MagicPhoenix/MPX-VORON-24R2-KIT/README.md

# VORON 2.4R2 KIT 

Repository for MagicPhoenix 2.4 R2 KIT.

For more detail, please visit https://mpx.wiki 

## Note

This repo is for old kits, for CBT kit please check https://github.com/MagicPhoenix/MPX-VORON-24R2-CBT
