MagicPhoenix/MPX-VORON-24R2-KIT/Assembly/PSU_Mount_Printed_Parts.png

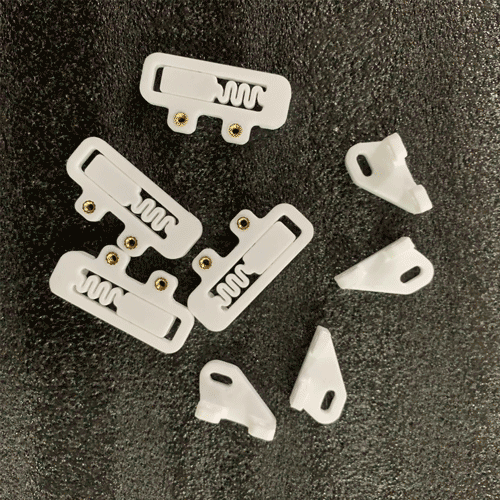
Assembly/PSU_Mount_Printed_Parts.png
