MagicPhoenix/MPX-VORON-24R2-KIT/Printed Parts/Canbus/canable_pro_clip.stl

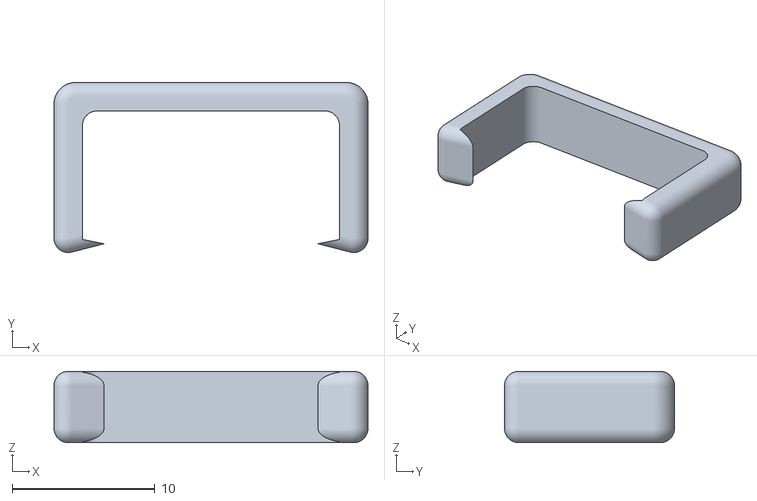
[picture p2: CAD file, 2023-08-08]
Printed Parts/Canbus/canable_pro_clip.stl
22.0 x 11.9 x 5.00
