MagicPhoenix/MPX-VORON-24R2-KIT/Printed Parts/Electronics_Mount/Rpi_Mount.STL

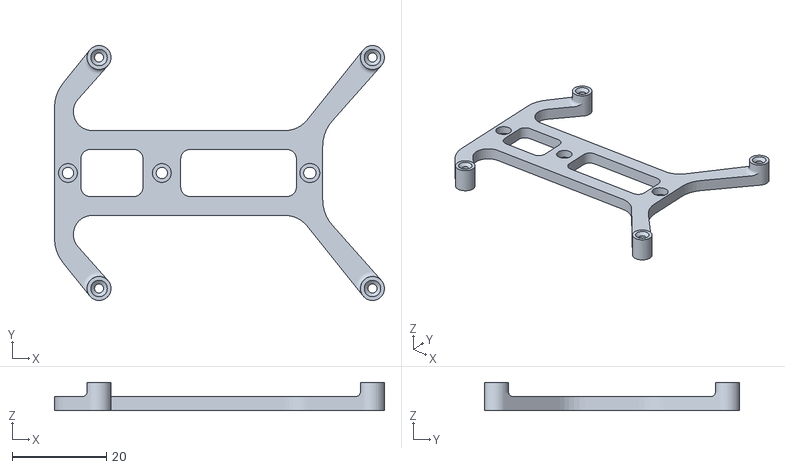
[picture p3: CAD file, 2022-06-08]
Printed Parts/Electronics_Mount/Rpi_Mount.STL
70.0 x 54.1 x 6.00
