MagicPhoenix/MPX-VORON-24R2-KIT/Printed Parts/Toolboard_Afterburner/Afterburner_Cover.STL

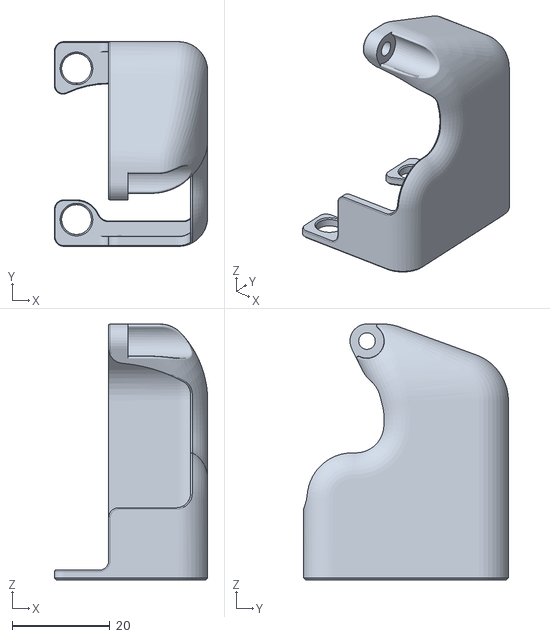
[picture p4: CAD file, 2022-04-11]
Printed Parts/Toolboard_Afterburner/Afterburner_Cover.STL
31.4 x 42.0 x 52.5
