MagicPhoenix/MPX-VORON-24R2-KIT/Printed Parts/Toolboard_Stealthburner/Stealthburner_Toolhead_PCB_Mount.STL

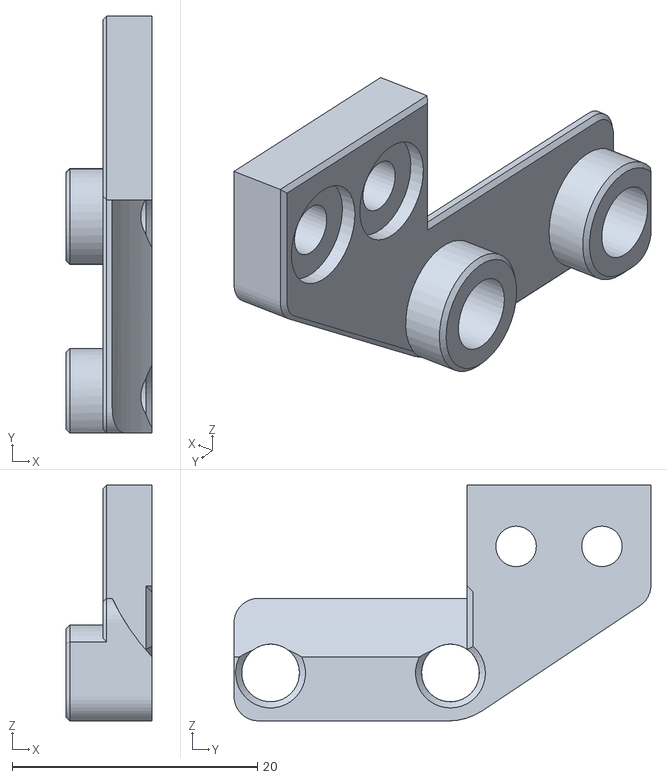
[picture p5: CAD file, 2022-04-03]
Printed Parts/Toolboard_Stealthburner/Stealthburner_Toolhead_PCB_Mount.STL
7.00 x 34.0 x 19.2
