MagicPhoenix/MPX-VORON-24R2-KIT/Printed Parts/Canbus/canable_pro_mount.stl

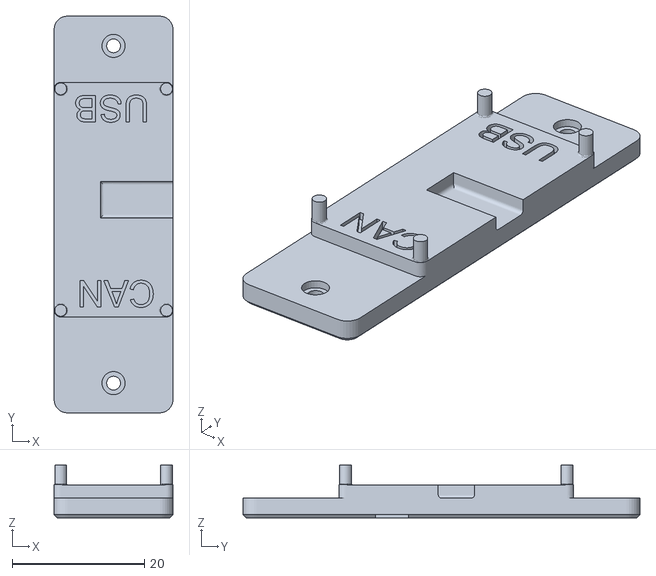
[picture p6: CAD file, 2023-08-08]
Printed Parts/Canbus/canable_pro_mount.stl
18.0 x 60.0 x 8.00
