MagicPhoenix/MPX-VORON-24R2-KIT/Printed Parts/Electronics_Mount/PSU_MOUNT_B_x2.stl

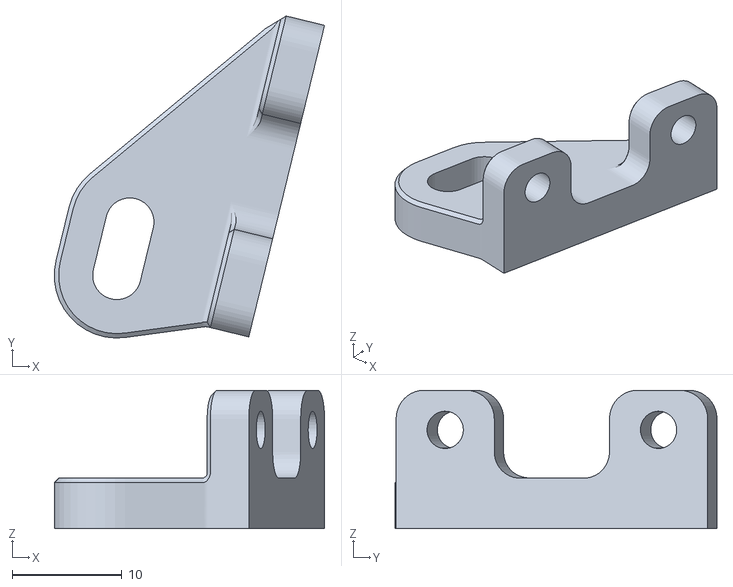
[picture p7: CAD file, 2022-04-09]
Printed Parts/Electronics_Mount/PSU_MOUNT_B_x2.stl
24.6 x 29.3 x 12.6
