MagicPhoenix/MPX-VORON-24R2-KIT/Printed Parts/Toolboard_Afterburner/Afterburner_Toolhead_PCB_Mount.STL

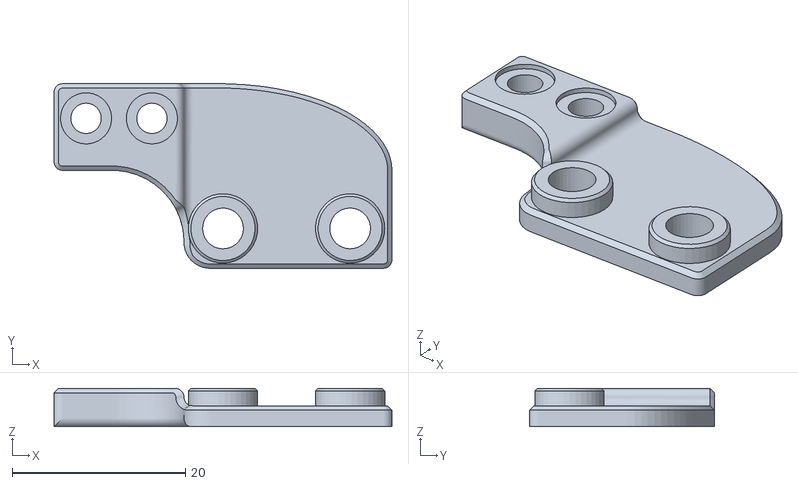
[picture p8: CAD file, 2022-04-11]
Printed Parts/Toolboard_Afterburner/Afterburner_Toolhead_PCB_Mount.STL
39.0 x 21.3 x 4.40
