MagicPhoenix/MPX-VORON-24R2-KIT/Printed Parts/Toolboard_Stealthburner/Stealthburner_Cover.STL

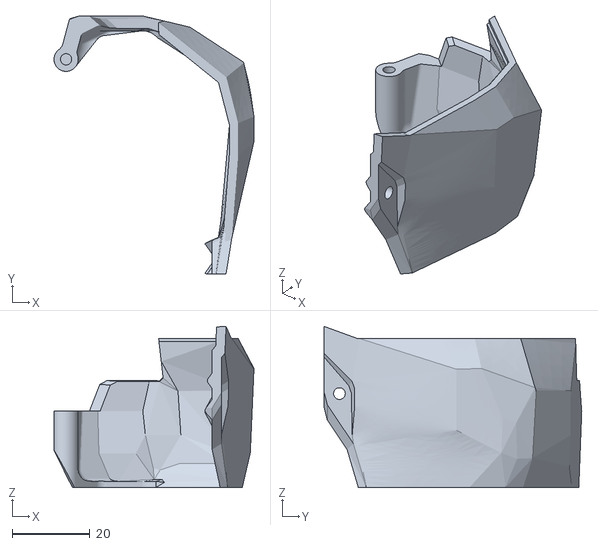
[picture p9: CAD file, 2022-04-03]
Printed Parts/Toolboard_Stealthburner/Stealthburner_Cover.STL
51.3 x 66.1 x 41.3
