MagicPhoenix/MPX-VORON-24R2-KIT/Printed Parts/Canbus/Y_endstop_cable_gland_A.stl

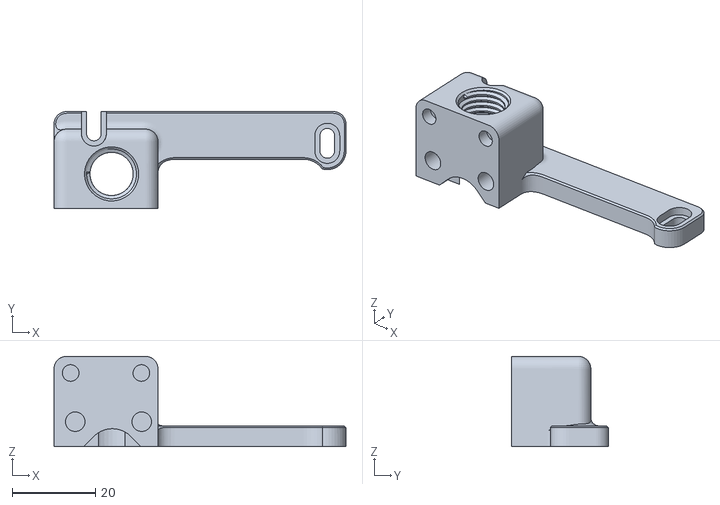
[picture p10: CAD file, 2022-08-02]
Printed Parts/Canbus/Y_endstop_cable_gland_A.stl
70.2 x 23.3 x 21.7
