MagicPhoenix/MPX-VORON-24R2-KIT/Printed Parts/Electronics_Mount/PSU_DIN_MOUNT_x4.stl

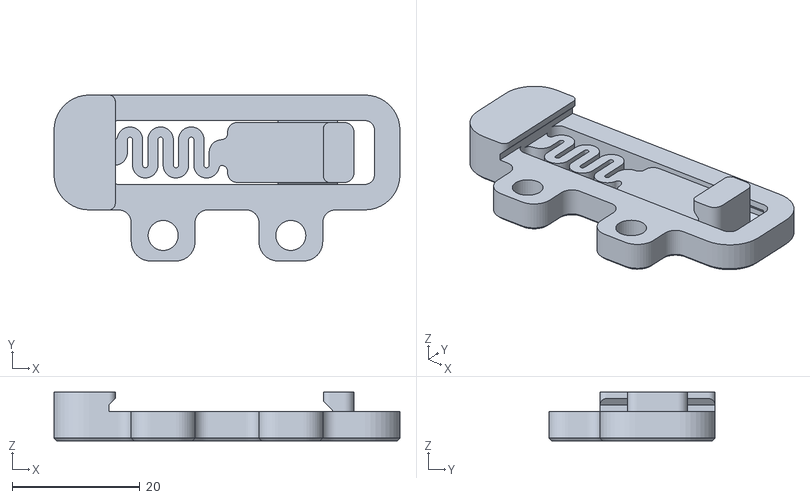
[picture p11: CAD file, 2022-04-03]
Printed Parts/Electronics_Mount/PSU_DIN_MOUNT_x4.stl
54.2 x 26.0 x 7.60
