MagicPhoenix/MPX-VORON-24R2-KIT/Printed Parts/Toolboard_Afterburner/Afterburner_Toolhead_Chain_Mount.STL

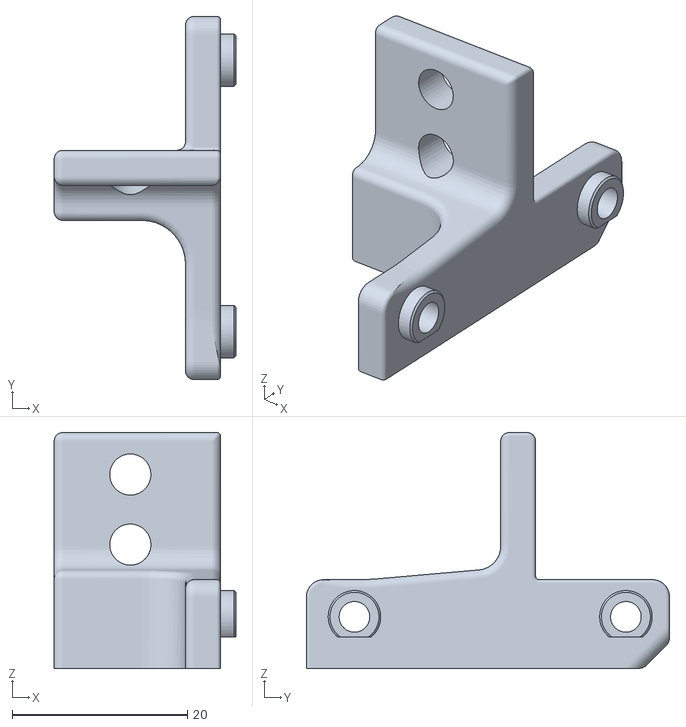
[picture p12: CAD file, 2022-04-03]
Printed Parts/Toolboard_Afterburner/Afterburner_Toolhead_Chain_Mount.STL
20.7 x 41.5 x 27.0
