MagicPhoenix/MPX-VORON-24R2-KIT/Printed Parts/Toolboard_Stealthburner/Stealthburner_Toolhead_Chain_Mount.STL

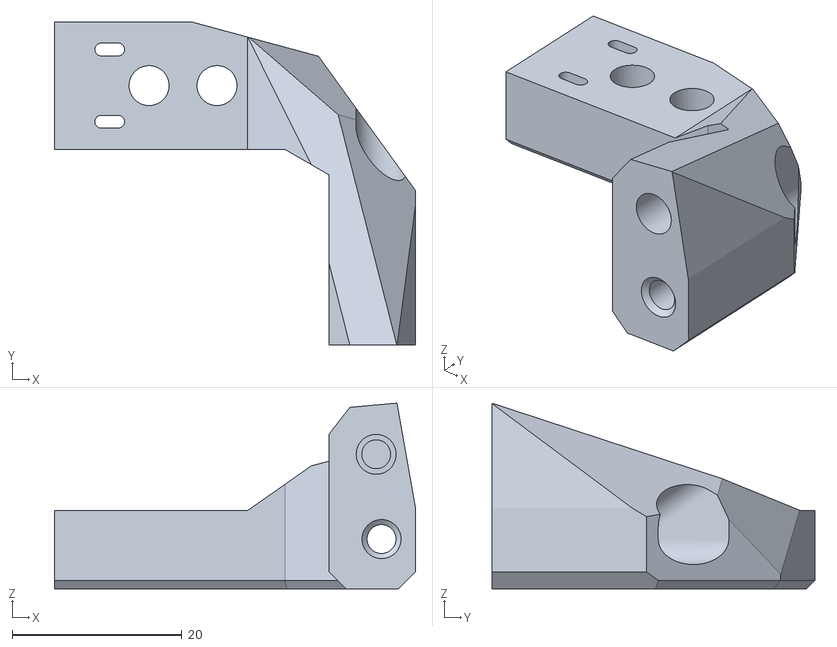
[picture p13: CAD file, 2022-04-03]
Printed Parts/Toolboard_Stealthburner/Stealthburner_Toolhead_Chain_Mount.STL
42.5 x 38.1 x 21.9
