MagicPhoenix/MPX-VORON-24R2-KIT/Printed Parts/Canbus/Y_endstop_cable_gland_B.stl

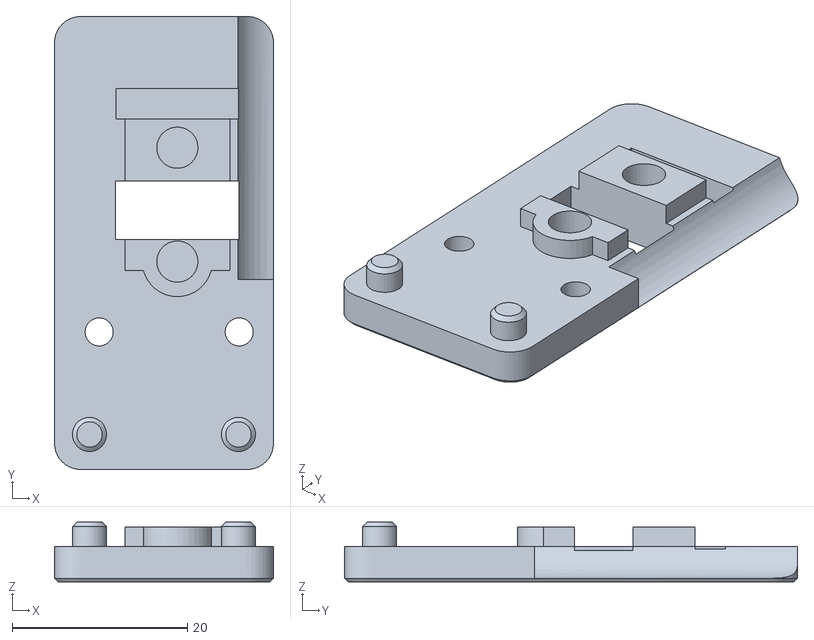
[picture p14: CAD file, 2022-08-02]
Printed Parts/Canbus/Y_endstop_cable_gland_B.stl
25.0 x 51.7 x 6.80
