MagicPhoenix/MPX-VORON-24R2-KIT/Printed Parts/Electronics_Mount/BreakoutPCB_DIN_MOUNT_x1.stl

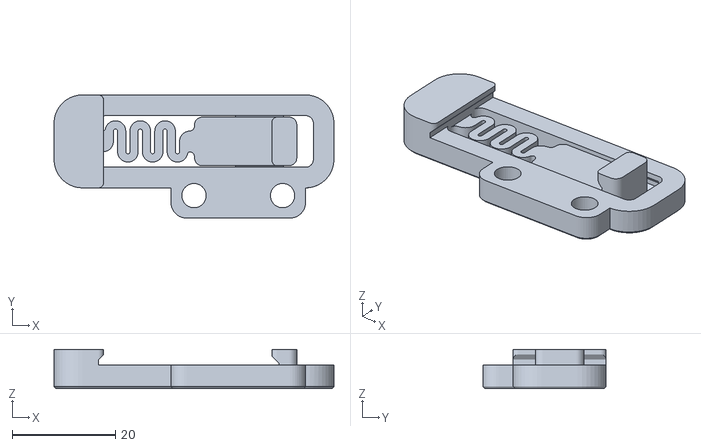
[picture p15: CAD file, 2022-04-03]
Printed Parts/Electronics_Mount/BreakoutPCB_DIN_MOUNT_x1.stl
54.2 x 23.8 x 7.60
