MagicPhoenix/MPX-VORON-24R2-KIT/Printed Parts/Canbus/CW1_EBB36_Mount.stl

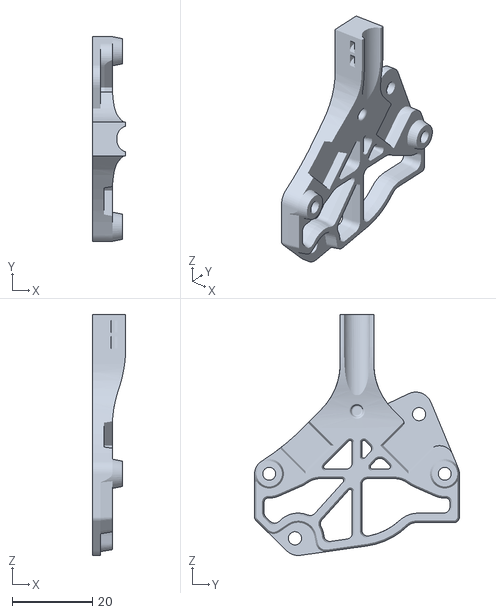
[picture p16: CAD file, 2022-07-23]
Printed Parts/Canbus/CW1_EBB36_Mount.stl
8.36 x 51.2 x 60.2
