MagicPhoenix/MPX-VORON-24R2-KIT/Printed Parts/Electronics_Mount/PSU_MOUNT_A_x2.stl

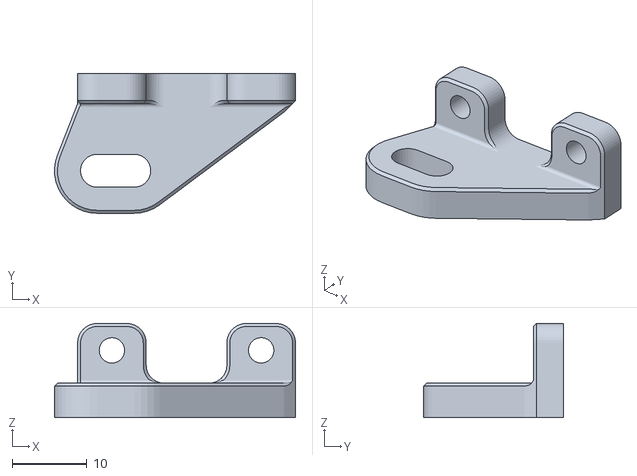
[picture p17: CAD file, 2022-04-03]
Printed Parts/Electronics_Mount/PSU_MOUNT_A_x2.stl
32.3 x 18.7 x 12.6
