MagicPhoenix/MPX-VORON-24R2-KIT/Printed Parts/Canbus/U2C_Mount.STL

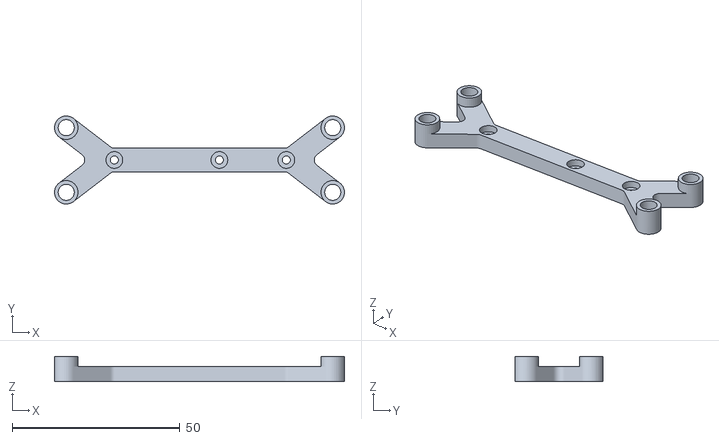
[picture p18: CAD file, 2022-07-20]
Printed Parts/Canbus/U2C_Mount.STL
86.3 x 26.2 x 7.50
