MagicPhoenix/MPX-VORON-24R2-KIT/Printed Parts/Canbus/CW2_EBB36_Mount.stl

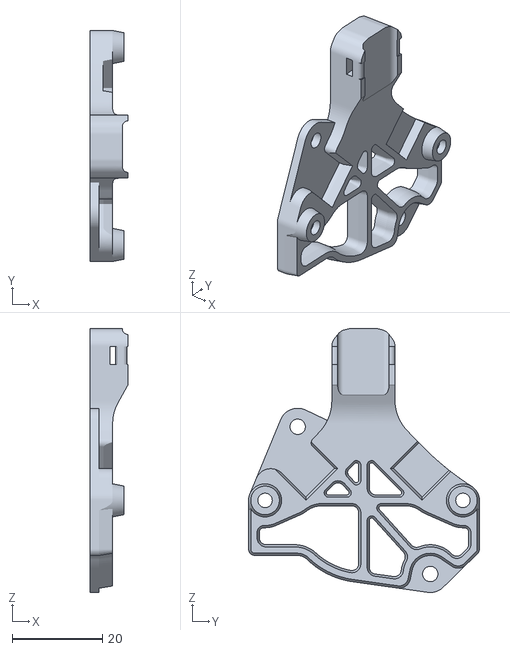
[picture p19: CAD file, 2022-07-20]
Printed Parts/Canbus/CW2_EBB36_Mount.stl
8.36 x 51.2 x 58.5
