MagicPhoenix/MPX-VORON-24R2-KIT/Assembly/Breakout_PCB_Mount_1.png

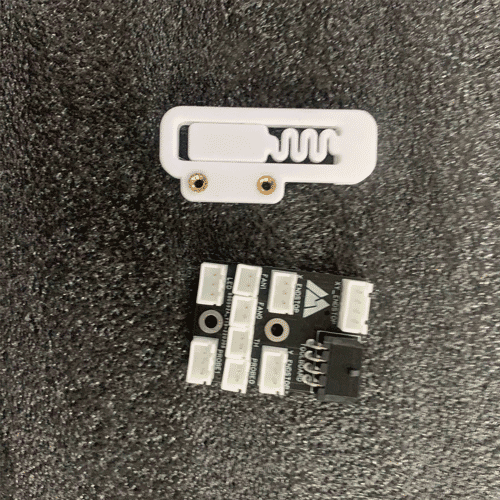
Assembly/Breakout_PCB_Mount_1.png
