MagicPhoenix/MPX-VORON-24R2-KIT/Assembly/Breakout_PCB_Mount_2.png

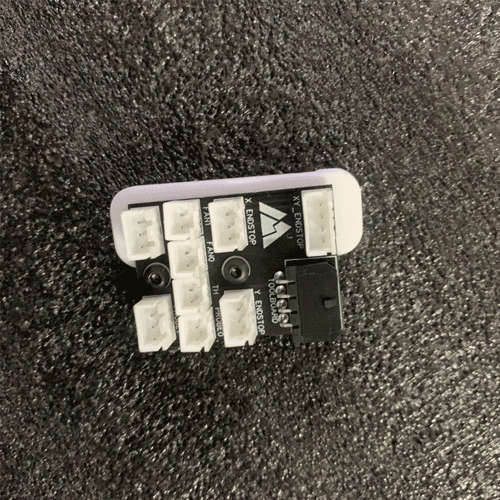
Assembly/Breakout_PCB_Mount_2.png
