MagicPhoenix/MPX-VORON-24R2-KIT/Assembly/Layer_1.png

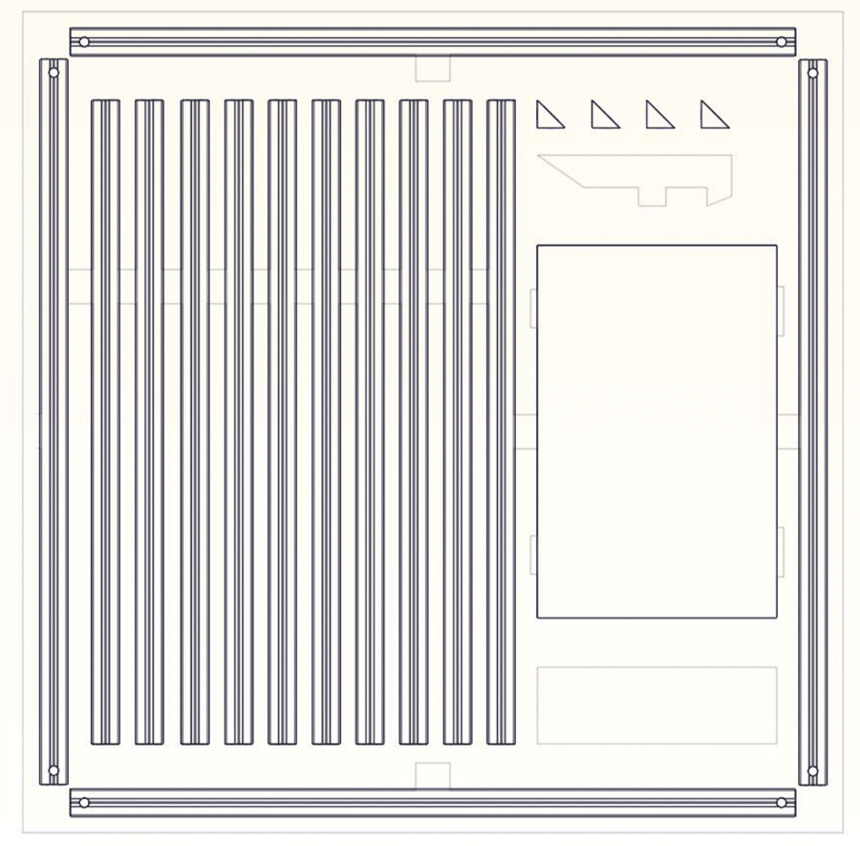
Assembly/Layer_1.png
