MagicPhoenix/MPX-VORON-24R2-KIT/Assembly/Layer_1_build.png

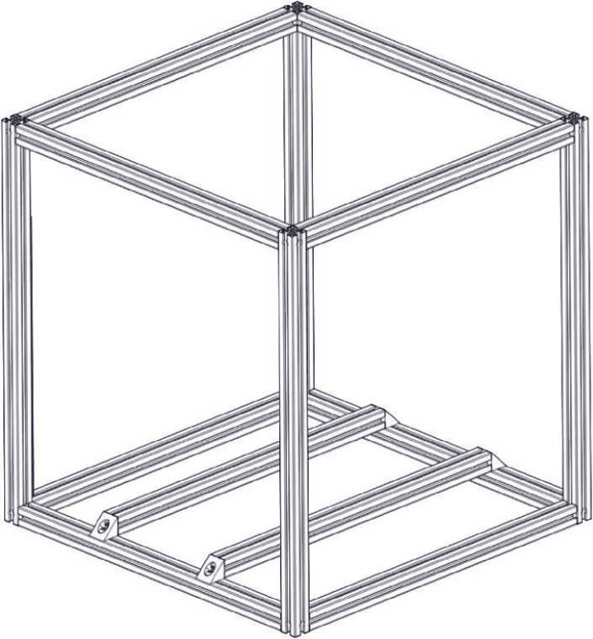
Assembly/Layer_1_build.png
