MagicPhoenix/MPX-VORON-24R2-KIT/Assembly/Layer_2.png

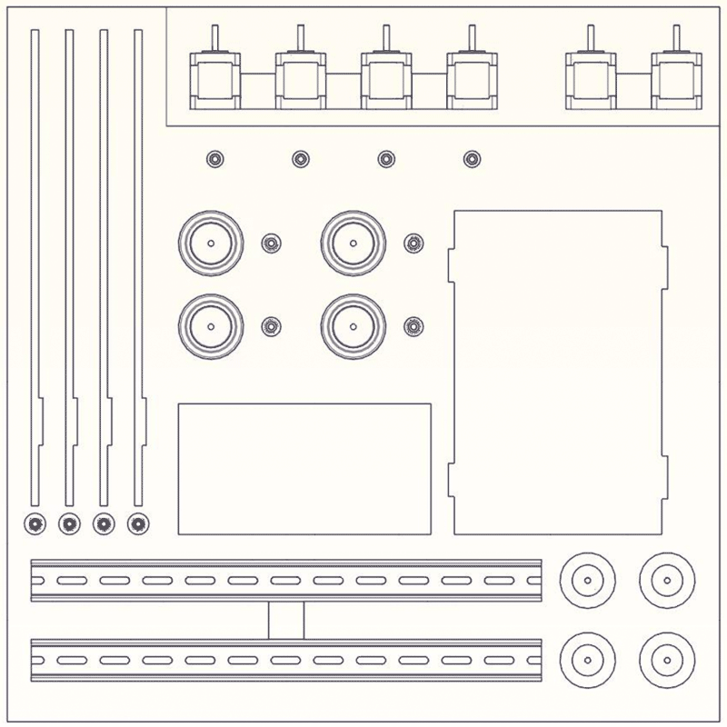
Assembly/Layer_2.png
