MagicPhoenix/MPX-VORON-24R2-KIT/Assembly/Layer_3.png

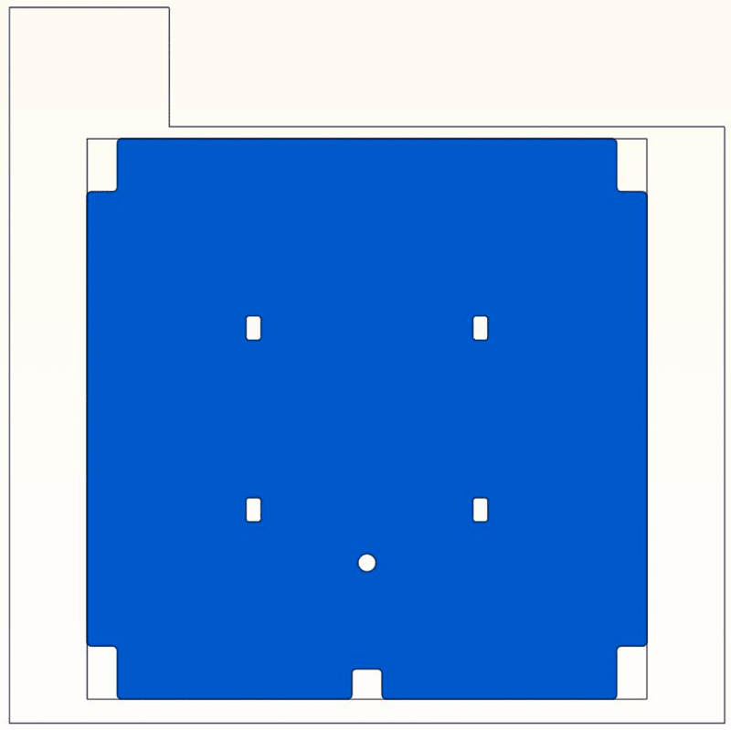
Assembly/Layer_3.png
