MagicPhoenix/MPX-VORON-24R2-KIT/Assembly/Layer_23_build.png

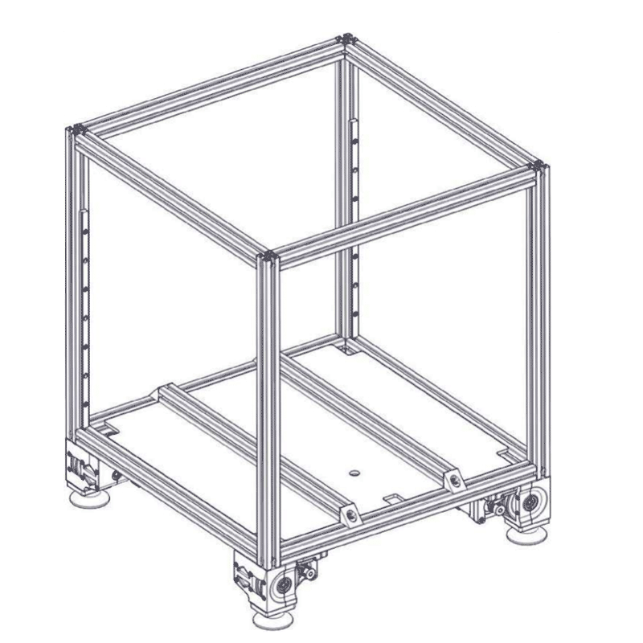
Assembly/Layer_23_build.png
