MagicPhoenix/MPX-VORON-24R2-KIT/Assembly/PSU_Mount.png

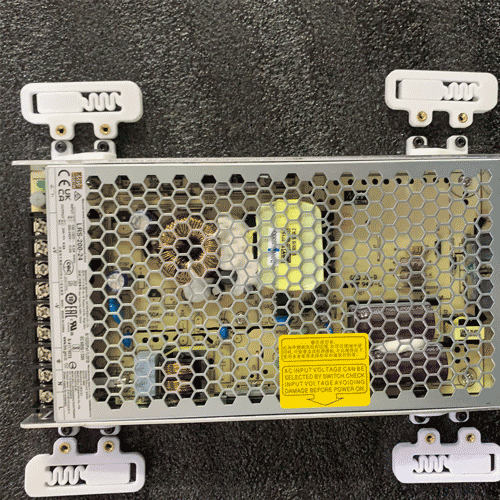
Assembly/PSU_Mount.png
