MagicPhoenix/MPX-VORON-24R2-KIT/Assembly/PSU_Mount_AB.png

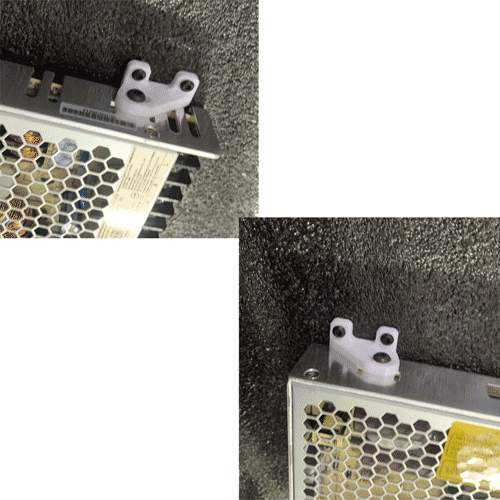
Assembly/PSU_Mount_AB.png
