MagicPhoenix/MPX-VORON-24R2-KIT/Assembly/Toolboard_PCB_Mount_1.png

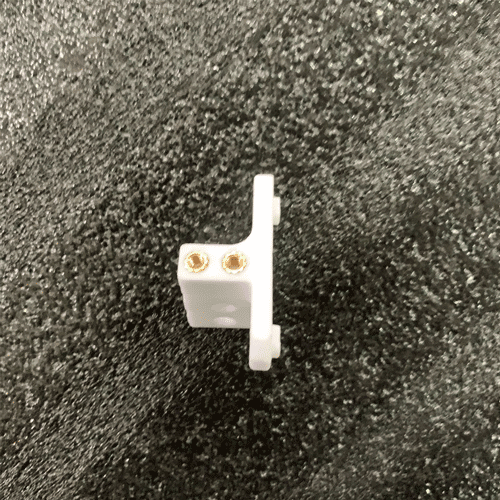
Assembly/Toolboard_PCB_Mount_1.png
