MagicPhoenix/MPX-VORON-24R2-KIT/(commit log)

2022-04-03 init commit
    [Afterburner_Cover.STL, Afterburner_Toolhead_Chain_Mount.STL, Afterburner_Toolhead_PCB_Mount.STL, BreakoutPCB_DIN_MOUNT_x1.stl, PSU_DIN_MOUNT_x4 v1.stl, PSU_MOUNT_A_x2.stl, PSU_MOUNT_B_x2.stl, Rpi_Mount.STL]
2022-04-07 basic firmware and wiring guide
    [printer.cfg]
2022-04-09 fixed orientation
    [PSU_MOUNT_B_x2.stl]
2022-04-09 Update Wiring Guide.md
2022-04-09 rebuild wiring guide
2022-04-11 update STL files
    [Afterburner_Cover.STL, Afterburner_Toolhead_PCB_Mount.STL, klicky-probe.cfg]
2022-04-19 add sexbolt file
    [EndstopHousingVoronLogo.stl]
2022-05-17 fixed exhaust_fan pin
    [printer.cfg]
2022-06-08 Update Rpi_Mount.STL
    now it can fit both R1 and R2 version's DIN clip
    [Rpi_Mount.STL]
2022-06-11 add sb_led config
    [stealthburner_leds.cfg]
2022-07-09 update klicky
    [klicky-bed-mesh-calibrate.cfg, klicky-macros.cfg, klicky-quad-gantry-level.cfg, klicky-variables.cfg]
2022-07-20 update canbus files
    [CW_2_EBB36_Mount.stl, PSU_DIN_MOUNT_x4.stl, UC2_Mount.STL, Y_endstop_cable_gland_1.STL, Y_endstop_cable_gland_2.STL]
2022-07-21 fixed name
    [U2C_Mount.STL]
2022-07-25 add canbus firmware
2022-08-02 update Y endstop station
    [Y_endstop_cable_gland_A.stl, Y_endstop_cable_gland_B.stl]
2022-08-24 fix EBB X endstop and klicky
2022-08-27 Update OCTOPUS-wiring.png
    fixed A/B stepper position
2022-10-02 Update printer.cfg.canbus
    ebb's pt100 config and heater_pin for 1.2
2022-10-10 printer.cfg update
    [printer.cfg]
